paum007/NR-Internship/circuit_design.png

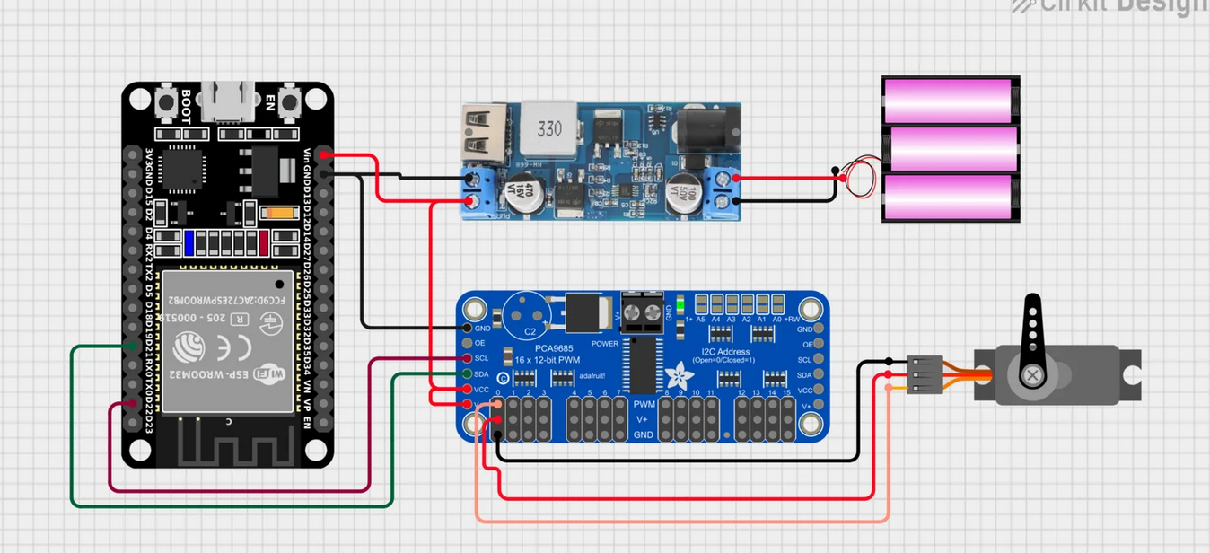
circuit_design.png
