paum007/NR-Internship/Pictures-and-videos/Dragonskin-60-mould.jpeg

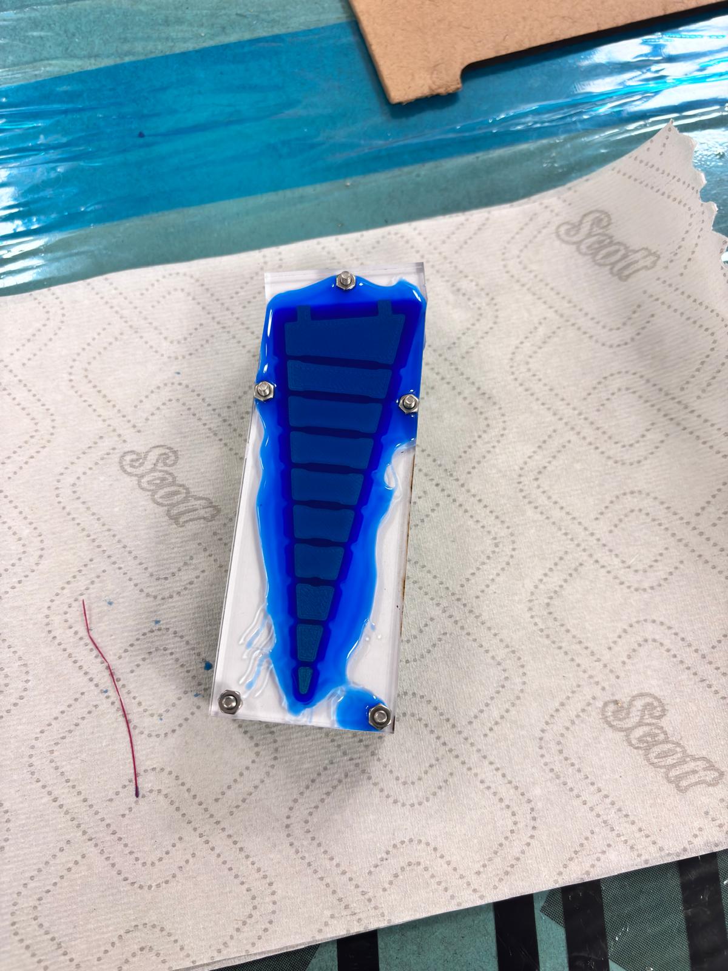
Pictures-and-videos/Dragonskin-60-mould.jpeg
