paum007/NR-Internship/Meeting notes/04-06-2026.md

For presenting: Use block diagrams that show the hardware and process of the project. Ask Adip the software that he used.
OpenVLA model for computer vision.

Take a look at the Dex MimicGEN: https://dexmimicgen.github.io/

Make an Excel Spreadsheet on the materials and equipment I'll need

RGB-D camera
