paum007/NR-Internship/Documents/Embodied Teleoperation and Imitation Learning for Human-like Robotic Manipulation.pptx

## Embodied Teleoperation and Imitation Learning for Human-like Robotic Manipulation

Pau M. Marcos

## OVERVIEW

- Hardware

- X-Arm
- Robotic hand end-effector with haptic feedback
- Cameras for computer vision
- IMU sensors for hand acceleration

- Manipulation

- Conducted testing with young business owners in the area

- Results

- Designed with the help and input of architecture experts in the field

- Testing

- First beautifully designed building that's both stylish and functional

Pitch deck title

## Workflow

## Timeline

## B.O.M.

Hand
Servos
Wire/fishing line
Haptic Sensors
Glove
Vision

## THANK YOU

- Mirjam Nilsson
- 206-555-0146
- mirjam@contoso.com
- www.contoso.com
