paum007/NR-Internship/Documents/NR Project Research.docx

# NR Project Research

Workflow, some ideas for the methodologies to be followed, equipment needed and a plan for the results.

- How are you going to get haptic feedback
- How are you going to move the arm accurately with a camera – remember to include something with the waypoints so that the arm knows which way to move
- How are the movements of the hand going to be translated to the robotic hand
- What are the plans for the results?

# E-Skin

There are types of actuators for the hand:

1. Linear Resonant Actuator: a small haptic device that vibrates linearly when driven by an AC signal. Can only convey pressure and no textures
2. Voice coil actuators: like tiny speakers pressed against skin. Better frequency response, can simulate textures.
3. Electrotactile stimulation: small electrodes pass tiny currents through skin to stimulate nerves directly. Very thin, high resolution, but tuning is tricky and sensation varies by person.
4. Shape memory alloys (SMA) or dielectric elastomer actuators (DEAs): research-grade, thin, but harder to drive.

## Linear Resonant Actuators

### What are they and how do they work?

An LRA Is a vibration motor that produces an oscillating force across a single axis. An LRA relies on an AC voltage to drive a voice coil pressed against a moving mass connected to a spring. When the voice coil is driven at the resonant frequency of the spring, the entire actuator vibrates with a perceptible force. Although the frequency and amplitude of a linear resonant actuator may be adjusted by changing the AC input, the actuator must be driven at its resonant frequency to generate a meaningful amount of force for a large current.

Although the frequency can be changed, the LRA will typically be operated within a narrow frequency range to optimise its power consumption; if the device is driven at the resonant frequency of the spring, it will consume less power to produce a vibration of equal magnitude.

The typical start time of the LRA is approximately 10ms. This incredible speed results from the immediate movement of the magnetic mass as current is applied to the voice coil inside of the device. Unfortunately, the stop time of the LRA can be longer. It can take up to 300ms to stop vibrating due to the continued storage of kinetic energy in the internal spring during operation. Thankfully, an active braking mechanism can also be used for an LRA—by performing an 180-degree phase shift of the AC signal provided to the actuator, the vibration can be stopped very quickly (within approximately 10ms) by producing a force opposite to the oscillation of the spring.

### Pros & Cons

Pros

- Size: Very small, good for physical flexibility.
- Price: These are cheap sensors (~£10).
- Fast response time.
- Long lifespan.
- Multidimensional haptic expression: it supports multi-mode waveform programming, this means it can be programmed to achieve various effects such as crisp clicks, gentle pulsations, gradual reminders, or complex sequences.

Cons

- More equipment needed to deal with the back current from the AC circuit
- High-performance loss: Vibration intensity drops sharply when the drive frequency deviates. A 10% deviation can cause a 30% or greater loss.
- Limited haptic effect: It is hard to maintain a consistent haptic experience over a wide frequency range. This limits the diversity of HD Haptics and complex waveforms.

### Feasibility and Expenses

The size and price make it feasible for the LRA to be used on a glove. These would be placed in between the joints in the hand and would act mainly to detect the pressure when the haptic sensors on the hand output a signal.

## Voice Coil Actuators

### What are they and how do they work?

VCAs are direct-drive, linear motors that offer precise motion control. They function by having an electric current flow through a voice coil, producing a magnetic force that drives linear movement.

They have 3 main components: the voice coil, the permanent magnet and the magnetically permeable core. The voice coil is a coil of wire, typically made of copper, wound around a bobbin. The permanent magnet generates a static magnetic field, while the core is used to concentrate the magnetic flux and provide a low-reluctance path for the flux lines.

When an electric current flows through the voice coil, it produces a magnetic field. This magnetic field interacts with the static magnetic field generated by the permanent magnet, creating a force. The direction and magnitude of these forces are determined by the direction and magnitude of the current flowing through the voice coil. This force is then transferred to the load, causing it to move in a linear motion.

### Types of VCAs

There are two types of VCAs: moving magnet and moving coil. In both types, the basic working principle remains the same, but the construction and arrangement of components differ.

#### Moving magnet VCAs

In a moving magnet VCA, the voice coil is stationary, while the permanent magnet is attached to the moving part of the actuator. This design has a lower moving mass and reduced inertia, allowing for faster response times and higher acceleration rates. However, the moving magnet design may be more susceptible to external magnetic fields and may require additional shielding (this might make it a bulkier design).

#### Moving coil VCAs

In a moving coil VCA, the permanent magnet is stationary, while the voice coil is attached to the moving part of the actuator. This design has the advantage of better heat dissipation (good for long usage), as the heat generated in the voice coil can be easily transferred to the surrounding environment. However, the moving coil design generally has a higher moving mass and inertia which may result in lower response times and lower acceleration rates compared to moving magnet VCAs (not good if the goal is to test for responsivity in remote environments).

### Pros & Cons

Pros

- High Precision: VCAs are capable of providing extremely precise positioning and control with resolutions down to the nanometre range.
- Fast Response: Due to their low moving mass and direct-drive design, VCAs can achieve very high acceleration rates and fast response times.
- Long Life: With no mechanical contact between the moving parts, VCAs have a long operational life and require minimal maintenance.
- Wide Force Range: The force generated by VCAs can be easily controlled by adjusting the current supplied to the voice coil, allowing for a wide range of forces to be produced.

Cons

- Larger and heavier — smallest practical size around 8–10mm, often thicker (4–6mm)
- Higher power draw, especially at low frequencies (which are inefficient)
- More complex driving: need an audio-style amplifier (Class D), not a simple haptic driver chip. You're essentially building a multi-channel audio system.
- More expensive: £10–30 per unit for decent quality
- Harder to find at small sizes from accessible suppliers
- Need to manage heat in continuous operation
- Frequency response varies with mounting pressure and skin contact — harder to calibrate consistently

### Feasibility and Expenses

Due to their more bulky and expensive nature, these can be used in the parts of the hand that are more used, this can include the fingertips. This will allow for some texture while the LRA can be used on the rest of the palm for pressure feedback.

## Electrotactile Stimulation Sensors

### What are they and how do they work?

Electrotactile stimulation is a fundamentally different approach to haptics: instead of mechanically pushing on skin, you pass small electrical currents through the skin to directly stimulate the sensory nerves underneath. The brain interprets these signals as touch sensations — tingling, pressure, vibration, or sharpness depending on how you drive them.

### Pros & Cons

Pros

- Ultra-thin: electrodes can be printed conductive ink, copper foil, or hydrogel pads — fractions of a millimetre thick. The glove can be genuinely skin-like.
- No moving parts: nothing to wear out, no resonant frequency limits, completely silent
- High spatial resolution: electrode pads can be 2–3mm, packed into dense arrays. Researchers have built 8×8 grids on a fingertip.
- Broadband sensation control: by varying frequency, pulse width, and amplitude independently, you can convey pressure, texture, vibration, and even sharpness/dullness
- Low power: microamps average current, runs forever on a small battery
- Fast response: no mechanical inertia, microsecond-scale onset
- Can stimulate specific receptor types: tuning parameters can preferentially excite Merkel cells (pressure), Meissner corpuscles (light touch), or Pacinian corpuscles (vibration)

Cons

- Sensation is unfamiliar and variable: it doesn't feel exactly like real touch, especially at first. Users describe it as "tingly pressure" or "buzzy sensation". Takes training to interpret.
- Highly person-dependent: skin impedance varies with hydration, hair, calluses, individual physiology. What feels gentle on one person feels sharp on another. Every user needs calibration.
- Sensitive to electrode contact: dry skin, sweat, electrode lift-off all changes the sensation. Hydrogel electrodes work best but dry out over hours.
- Narrow window between perceptible and painful: maybe a 3–5× range between "I feel it" and "ow". LRAs and VCAs have much wider comfort margins.
- Safety considerations: high voltage near skin requires proper isolation. Not dangerous when designed correctly (TENS units use the same principle medically), but you need to handle this seriously.
- Driver electronics are non-trivial: you need high-voltage boost converters, current-controlled output stages, biphasic pulse generation, and per-electrode multiplexing. Far more complex than driving an LRA.
- Regulatory friction: anything that puts current through skin can attract medical device classification if you commercialise. For personal/research use it's fine.
- Habituation and discomfort over time: prolonged stimulation can cause skin irritation, especially with gel electrodes. Sessions over an hour become uncomfortable.

## Dielectric Elastomer Actuators

### What are they and how do they work?

Dielectric elastomer actuators (DEA) are a class of electroactive polymers which work based on inducing of deformation of an electric field. A common design of DEAs is to sandwich a soft insulating elastomer membrane between two compliant electrodes. When a voltage is applied between the electrodes, the arising electric field causes a decrease in thickness and increase in area of the membrane.

What If I do something like this (https://www.youtube.com/watch?v=2yF-SJcg3zQ) with the potentiometers as well as with VCAs

## PowerPoint plan:

- 5 informative slides
- block diagram, including inputs/outputs, methods, and arrows connecting them to show the overall flow.
- A Gantt chart with a bi-weekly plan of the expected tasks would also be very useful (look at the official proposal doc).
- you may also want to include the equipment already available in the lab.

Parts list:

- Flex resistors x5 -> roughly £50
- HEEPDD Haptic Motor Controller DRV2605L Module, I2C Control Tactile Actuator Board Development Tool for Vibration Feedback in Robotics and Smartphones, High Performance Programmable Motor Driver -> roughly another £50
- ESP32 x2 -> already have so, £0
- Glove -> £2
- Servos for the hand -> already have so, £0
- Motors to provide resistance for the sensorised glove
- Also, VCA’s for haptic feedback on the tips of the fingers and possibly a bit of the hand as well
- Cable for the hand and the sensorised glove

Main issue is how do I detect if it’s grabbing something so that I can provide resistance on the glove?

Do I need encoders for the sensorised glove, or can it be done through resistance values?

I can test how long the cables need to be.

Find an already built hand design.

Ask for 3D printer access.
