paum007/NR-Internship/Documents/Presentation for NR Project GOOD.pptx

## Embodied Teleoperation and Imitation Learning for Human-like Robotic Manipulation

Pau M. Marcos

## Overview

- what it is + the contribution. Embodied teleoperation testbed; the thing that doesn't exist yet is the latency-swept dataset + reproducible benchmark. Lead with that, not the glove.

## Workflow

- Input/outputs
- Methods
- the closed loop as a diagram. Forward: hand → camera+IMU pose → IK → robot hand. Return: robot fingertip force → tendon brake (hard-stop) + VCA (tactile). This is your one diagram slide and the spine of the whole talk.

## Testing and Results

- NASA-TLX
- YCB object Dataset
- Replicability

## Method

- The method + why — combine the design problem, the alternatives, and your choice onto one slide. This is the compression that hurts, but it's the right call: pose "how do you render rigid resistance?", show the methods compressed to a small comparison (motor / brake / pad / pneumatic on the axes that matter), and land on the brake — resist-only is sufficient for rigid contact, so the brake wins on weight/power/safety/crispness. The "different methods" you originally wanted now live as a compact comparison here rather than their own section. You keep the "I navigated a design space" credibility without spending a whole slide on it.
- Equipment: X-Arm and access to the 3D printers, depth camera

## Timeline

- 9-weeks
- One week left de colchón por si necesito más tiempo en otras cosas o improvements

## Equipment Access

- wrist real-estate for five brakes, human↔robot finger mapping, and haptic-onset delay tying back to the latency theme. Close on the contribution again.
