paum007/NR-Internship/Documents/Embodied Teleoperation and Imitation Learning for Human-like Robotic Manipulation Presentation.pptx

01 / 05

Embodied Teleoperation and Imitation Learning for Human-like Robotic Manipulation

Real-time human control of a robotic hand and arm under controlled communication delay

Pau M. Marcos

## Slide 2

SYSTEM WORKFLOW

Control Loop

02 / 05

Return · feedback

Forward · command

Operator hand
flex sensor per finger

Camera + IMU
fused 6-DoF wrist pose

IK + mapping
human → end-effector

Robot hand
5 servos close

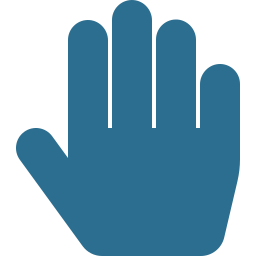
[picture p3: figure]
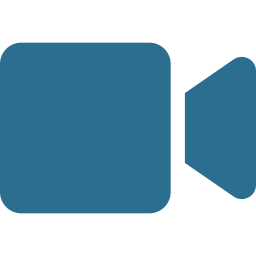
[picture p4: figure]
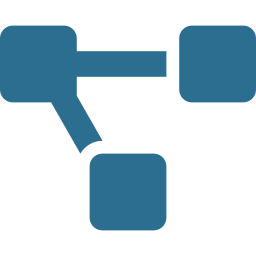
[picture p5: figure]
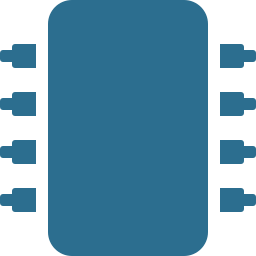
[picture p6: figure]

Tendon brake · kinesthetic
servo-clamp locks the close → hard stop

Contact
fingertip force sensed

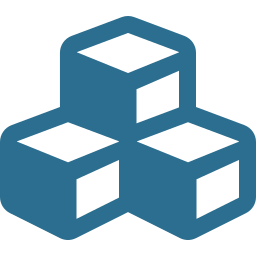
[picture p7: figure]

VCA · tactile
fingertip buzz on contact onset

The return path is part of the latency under study.
Haptic onset delay is a delay in this loop.

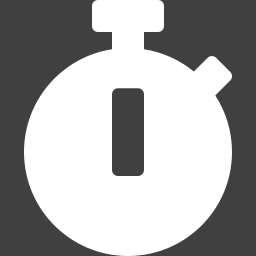
[picture p8: figure]

## Slide 3

RENDERING RESISTANCE

Feeling a rigid object: the tendon brake

03 / 05

Key insight: rigid contact is a hard stop, not a generated force. So, the device only needs to resist.

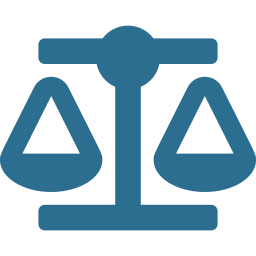
[picture p9: figure]

The per-finger method: command + resistance

A flex sensor on each glove finger sets its robot finger's position
Bend a finger and the matching robot finger closes — five fingers, five independent position commands.

Resist-only — all a rigid hard stop needs

No motor weight, power or safety burden

Crisp, fast lock feels like a real wall

Servo-clamp build reuses the ESP32

1

2

A tendon also runs along each glove finger
Anchored at the fingertip, routed back to a servo-driven clamp grounded against the hand / forearm.

3

On contact, the robot's fingertip force sensor fires
When that finger meets a rigid object, it raises a contact signal.

4

The clamp locks the tendon
The finger can't flex further; push harder and you feel more, like pressing a real wall.

Scope: rigid YCB subset only (boxes, cans). A rigid object never compresses, so a hard stop is sufficient — deformables would need force-dependent output and are out of scope.

## Slide 4

TESTING & RESULTS

Workload is what decides feasibility

04 / 05

PROTOCOL

Within-subjects:
each operator runs every condition.
Latency sweep (0 → <5 s) × haptic mode (brake on / off).
Counterbalanced order to cancel fatigue & learning effects.
Raw NASA-TLX taken immediately after each condition.

THE FEASIBILITY CEILING

Objective metrics say whether the task can be done. NASA-TLX says what it costs. As delay grows, success can hold while workload climbs — the point where workload turns unsustainable, though the task is still completable, is the feasibility ceiling. That gap, not task failure, limits real deployment.

MEASURES

Objective — can the task be done?
completion time · success rate · contact force
Subjective — what does it cost the operator?
NASA-TLX workload (mental, physical, temporal, performance, effort, frustration)

WHY IT MATTERS

Deployment — a system that's completable but cognitively punishing isn't usable for hazardous or remote work.
Contribution — workload becomes a logged axis of the dataset. Most teleoperation benchmarks record only objective metrics; adding a subjective-workload dimension is part of what makes this one reusable.

## Slide 5

10-WEEK WORK PLAN

Phased build

05 / 05

W1–2

System Setup + Hardware Integration

Depth camera, skeletal tracking, initial robot-hand interface, glove input.

W3–4

Control + Mapping Development

Human→robot motion mapping, IK, per-finger gripper actuation, stable loop.

W5–6

ROS2 Integration

Comms pipeline and configurable delay module (<5 s); nominal validation.

W7–8

Testing + Experimental Benchmarking

Contact-rich pick-and-place across latency & haptic modes; log time, success, force, NASA-TLX.

W9–10

Data Analysis + Learning Extension

Dataset → state-action pairs; demo-quality & degradation trends under delay.
