paum007/NR-Internship/Pictures-and-videos/Dragonskin-60-mould-1.jpeg

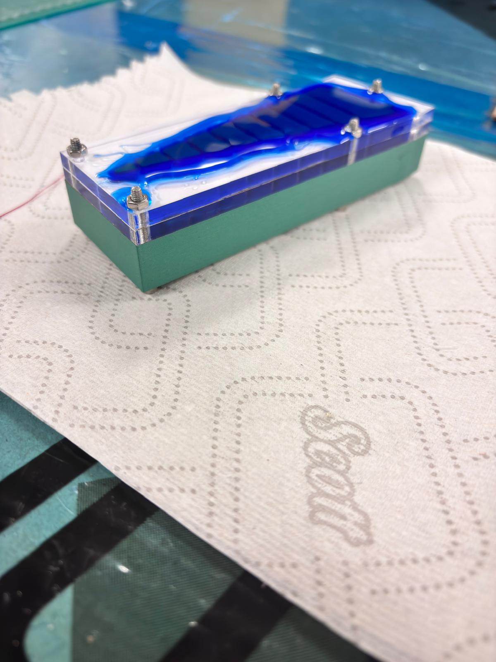
Pictures-and-videos/Dragonskin-60-mould-1.jpeg
