paum007/NR-Internship/Pictures-and-videos/Gripper-1.jpeg

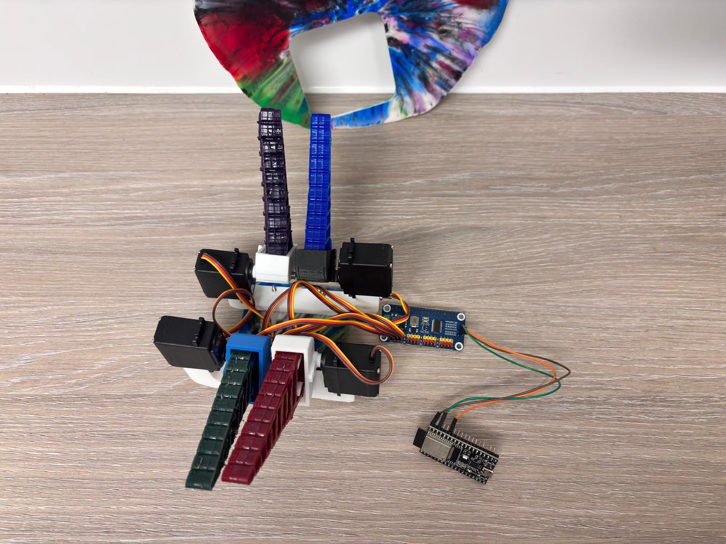
Pictures-and-videos/Gripper-1.jpeg
