paum007/NR-Internship/Pictures-and-videos/Gripper-2.jpeg

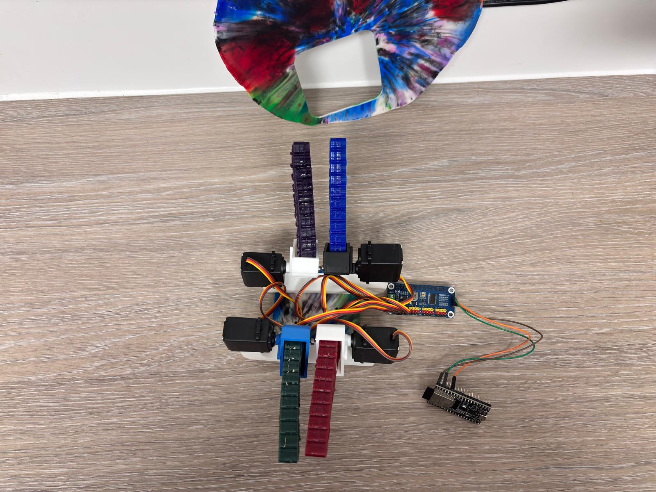
Pictures-and-videos/Gripper-2.jpeg
