paum007/NR-Internship/Pictures-and-videos/Gripper-3.jpeg

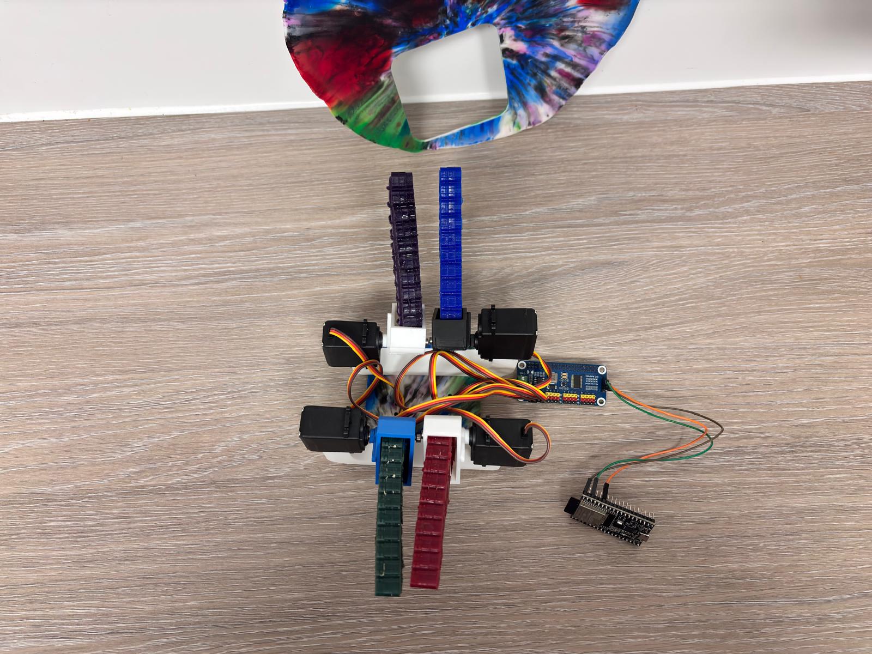
Pictures-and-videos/Gripper-3.jpeg
