paum007/NR-Internship/Pictures-and-videos/Gripper-4.jpeg

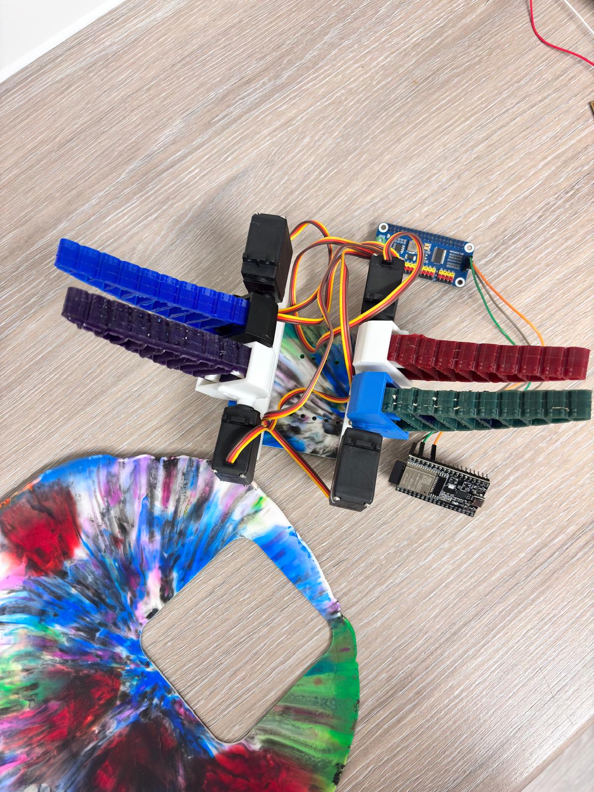
Pictures-and-videos/Gripper-4.jpeg
