paum007/NR-Internship/Pictures-and-videos/Plastic-sheet.jpeg

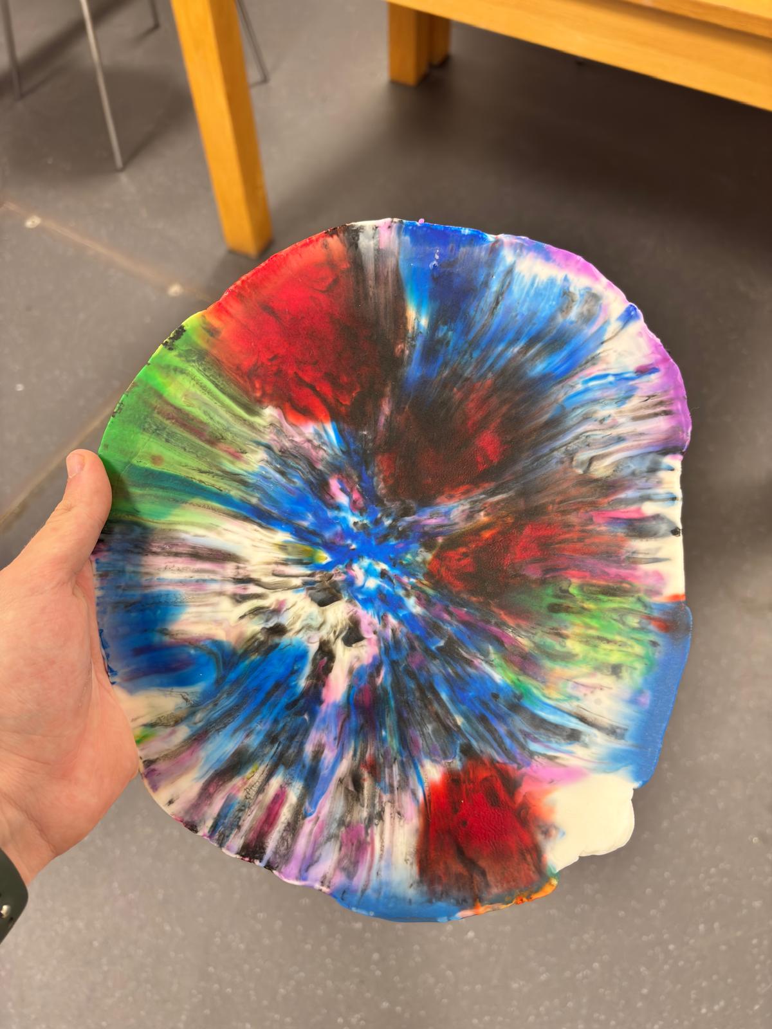
Pictures-and-videos/Plastic-sheet.jpeg
