paum007/NR-Internship/Pictures-and-videos/Plastic-waste-before-melting.jpeg

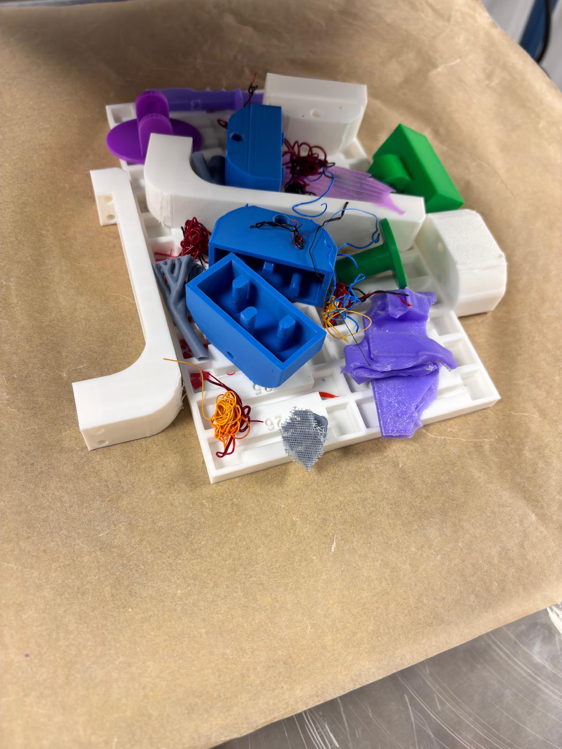
Pictures-and-videos/Plastic-waste-before-melting.jpeg
