paum007/NR-Internship/Pictures-and-videos/Vytaflex-mould.jpeg

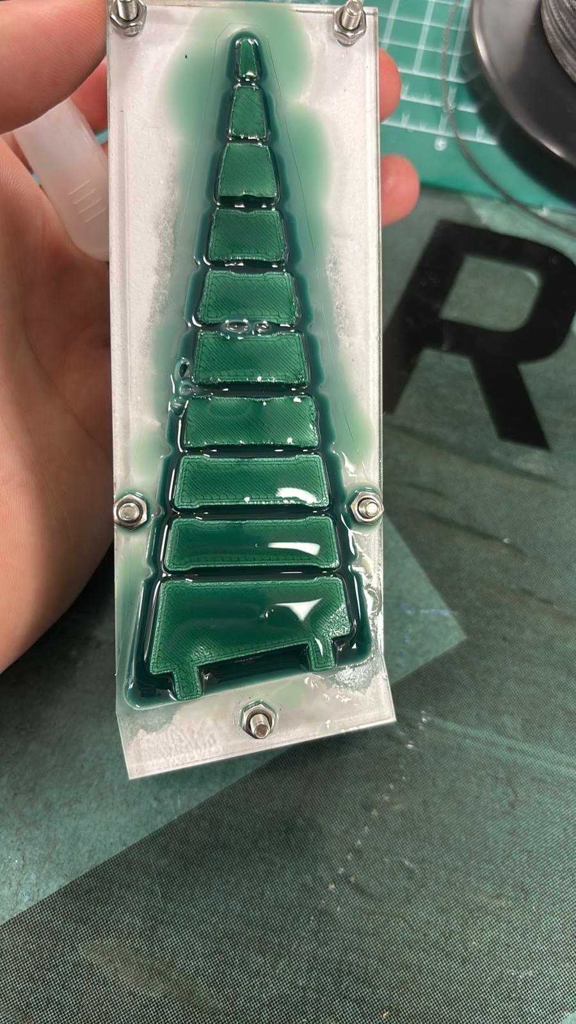
Pictures-and-videos/Vytaflex-mould.jpeg
