paum007/NR-Internship/CAD/xArm6 coupler.stl

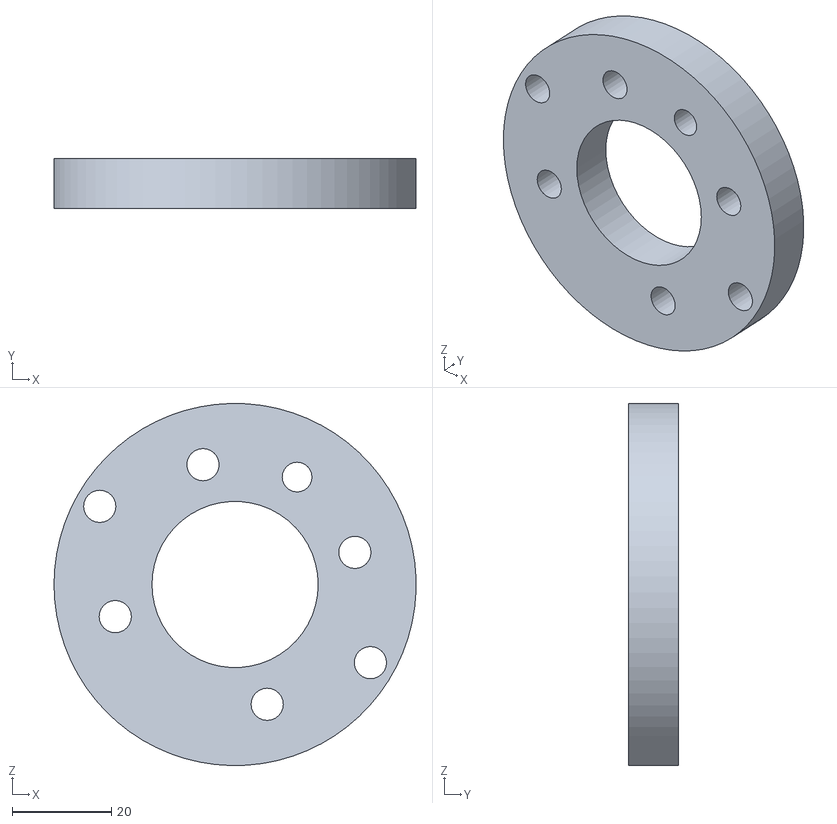
[picture p18: CAD file, 2026-08-27]
CAD/xArm6 coupler.stl
73.0 x 10.0 x 73.0
