paum007/NR-Internship/CAD/Finray laser file.dxf

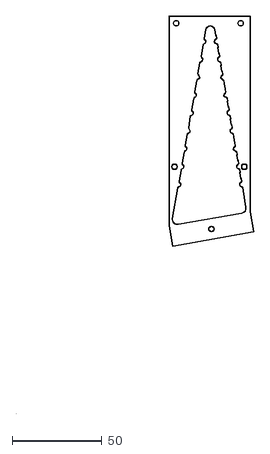
[picture p19: CAD file, 2026-08-24]
CAD/Finray laser file.dxf
132.5 x 221.8
