paum007/NR-Internship/CAD/Configuración 1.stl

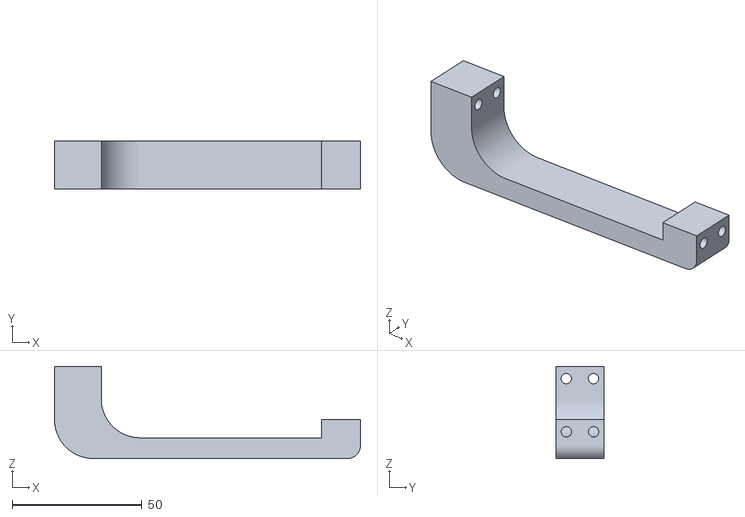
[picture p20: CAD file, 2026-08-24]
CAD/Configuración 1.stl
118.0 x 18.4 x 35.5
