paum007/NR-Internship/CAD/finray-mount.stl

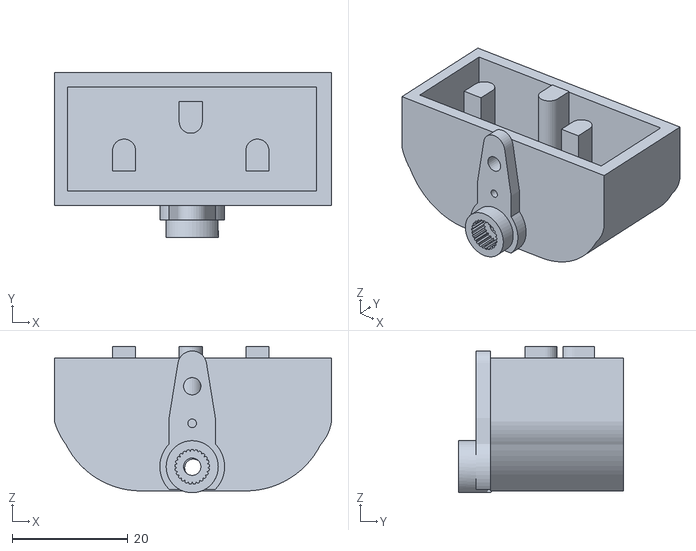
[picture p21: CAD file, 2026-08-24]
CAD/finray-mount.stl
47.9 x 28.5 x 25.3
