paum007/NR-Internship/CAD/flipped-finray-mount.stl

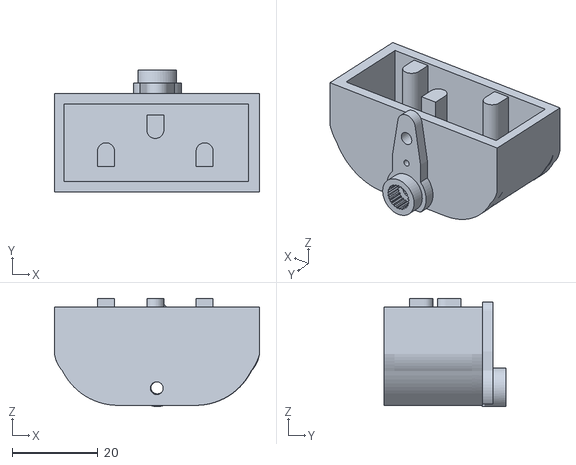
[picture p22: CAD file, 2026-08-24]
CAD/flipped-finray-mount.stl
47.9 x 28.5 x 25.3
