paum007/NR-Internship/CAD/MG966R-arm-pad.stl

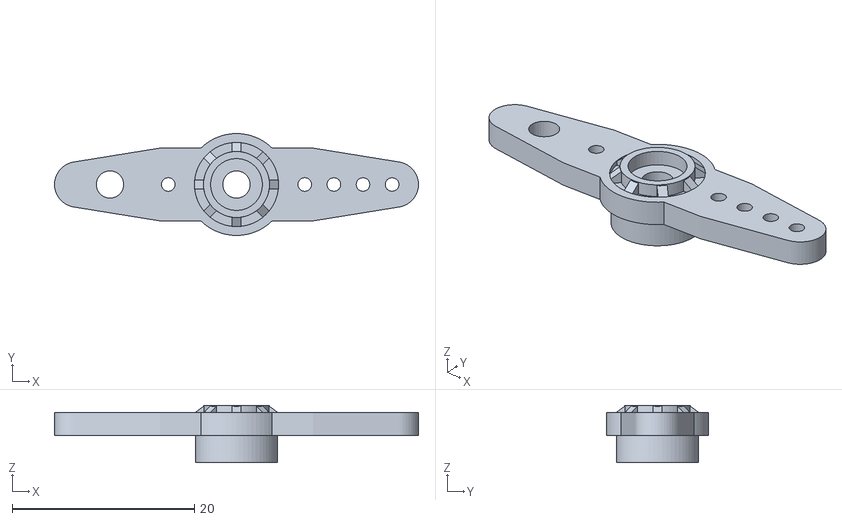
[picture p23: CAD file, 2026-08-24]
CAD/MG966R-arm-pad.stl
40.0 x 11.2 x 6.30
