paum007/NR-Internship/CAD/Finray mould v4.stl

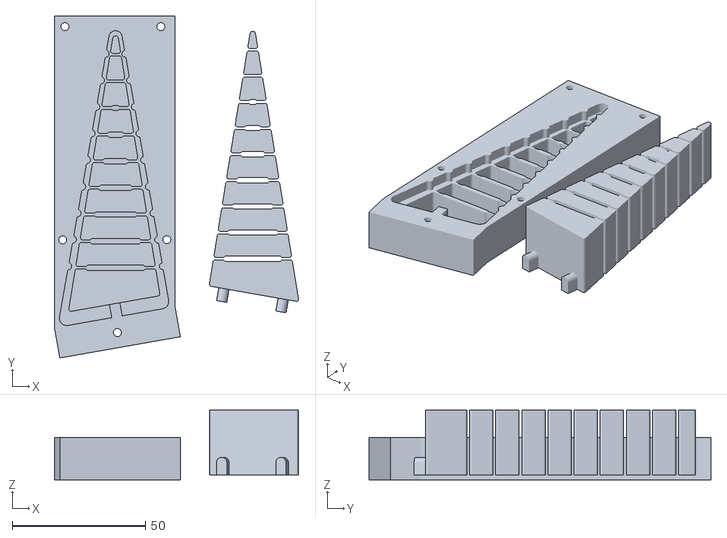
[picture p24: CAD file, 2026-08-04]
CAD/Finray mould v4.stl
91.6 x 128.3 x 26.2
