paum007/NR-Internship/CAD/Finray Attachment v1.stl

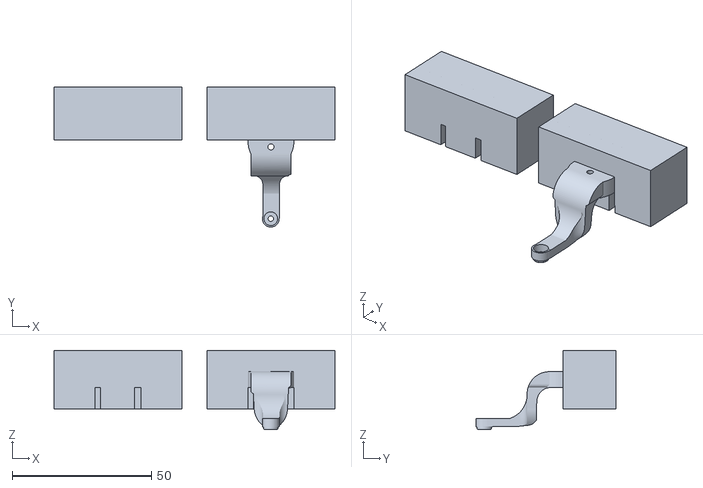
[picture p25: CAD file, 2026-07-31]
CAD/Finray Attachment v1.stl
101.0 x 50.4 x 28.5
