paum007/NR-Internship/(list of files, cad)

Other CAD files:
CAD/Finray Attachment v1.f3z
CAD/Finray mould v4.f3d
CAD/xArm6 coupler.f3d
