paum007/NR-Internship/esp_src/pio_ws/src/pca9685_testing.cpp

// This file was used to test the PCA9685 servo board to get familiar with it

#include <Wire.h>

// Include Adafruit PCA9685 Servo Library
#include <Adafruit_PWMServoDriver.h>

// Create object to represent PCA9685 at default I2C address
Adafruit_PWMServoDriver pca9685 = Adafruit_PWMServoDriver(0x40);

#define SERVOMIN 80  // Minimum value
#define SERVOMAX 600  // Maximum value
#define SER0 0   //Servo Motor 0 on connector 0
#define SER1 12  //Servo Motor 1 on connector 12

// Variables for Servo Motor positions (expand as required)
int pwm0;
int pwm1;

void setup() {
    
    // Serial monitor setup
    Serial.begin(115200);// Print to monitor
    Serial.println("PCA9685 Servo Test");// Initialize PCA9685
    pca9685.begin();
    pca9685.setPWMFreq(50);} // set pwm frequency to 50Hz
    
void loop() {
    
    // Move Motor 0 from 0 to 180 degrees
    for (int posDegrees = 0; posDegrees <= 180; posDegrees++) {
        
        // Determine PWM pulse width
        pwm0 = map(posDegrees, 0, 180, SERVOMIN, SERVOMAX);
        // Write to PCA9685
        pca9685.setPWM(SER0, 0, pwm0);
        // Print to serial monitor
        Serial.print("Motor 0 = ");
        Serial.println(posDegrees);
        delay(30);
    }
    
    // Move Motor 1 from 180 to 0 degrees
    for (int posDegrees = 180; posDegrees >= 0; posDegrees--) {
        
        // Determine PWM pulse width
        pwm1 = map(posDegrees, 0, 180, SERVOMIN, SERVOMAX);
        // Write to PCA9685
        pca9685.setPWM(SER1, 0, pwm1);
        pca9685.setPWM(1, 0, pwm1);
        pca9685.setPWM(7, 0, pwm1);
        // Print to serial monitor
        Serial.print("Motor 1 = ");
        Serial.println(posDegrees);
        delay(30);
    }
    
    // Move Motor 0 from 180 to 0 degrees
    for (int posDegrees = 180; posDegrees >= 0; posDegrees--) {
        
        // Determine PWM pulse width
        pwm0 = map(posDegrees, 0, 180, SERVOMIN, SERVOMAX);
        // Write to PCA9685
        pca9685.setPWM(SER0, 0, pwm0);
        pca9685.setPWM(SER1, 0, pwm0);
        pca9685.setPWM(1, 0, pwm0);
        pca9685.setPWM(7, 0, pwm0);
        // Print to serial monitor
        Serial.print("Motor 0 = ");
        Serial.println(posDegrees);
        delay(30);
    }
    
    // Move Motor 1 from 0 to 180 degrees
    for (int posDegrees = 0; posDegrees <= 180; posDegrees++) {
        
        // Determine PWM pulse width
        pwm1 = map(posDegrees, 0, 180, SERVOMIN, SERVOMAX);
        // Write to PCA9685
        pca9685.setPWM(SER1, 0, pwm1);
        // Print to serial monitor
        Serial.print("Motor 1 = ");
        Serial.println(posDegrees);
        delay(30);
    }

}
