paum007/NR-Internship/(commit log)

2026-06-04 File: Powerpoint on the planning and project initial ideas an dproposal
2026-06-04 File: Added a to-do list to keep track of the tasks
2026-06-07 Update: added a reminder to order a servo
2026-06-07 Feat: Finalised the hand design, it's compact and has space for the servos in a forearm-like container.
2026-06-08 FEAT: this file reads the data coming from the GY-521 IMU sensor
2026-06-08 FEAT: outputs the MAC address of the ESP32
2026-06-08 FEAT: this file receives the values from the potentiometer and moves the servos accordingly
2026-06-08 FEAT: config file for the ESP32. Tells the baudrate and settings as well as containing envs that push different code
2026-06-08 FEAT: very simple visualiser to se how the IMU sensor is working and how it's outputting data
2026-06-08 UPDATE: changed how the values are outputted by performing calculations so I can get pitch, roll and yaw
2026-06-16 NEW:CAD work for the haptic fingertip added
    [Fingertip1.stl]
2026-06-16 FEAT: This file moves 3 servos in a way that looks like a finger is curling
2026-06-16 UPDT: Added a print
2026-06-17 UPDT: Added settings for the printer and the datasheet for the magnetometer and stuff
2026-06-17 FEAT: Added the ros distro and the magnetometer code
2026-06-17 FEAT: Added code to read data from a magnetometer
2026-06-23 FEAT: Data gathering and data processing for the delay in microros
    [delay_data.csv]
2026-07-01 FEAT: Built the ROS2 workspace with the necessary files
    [delay_data.csv]
2026-07-02 FEAT: Made it to read a frame and output the angles between landmarks
2026-07-02 FEAT: Added an executor for the camera node
2026-07-02 FEAT: New node to read the angles from the mediapie node and translate them to the servo angles
2026-07-02 FEAT: Added a new environment for the new node to subscribe and move the servos
2026-07-08 FEAT: Added angle offset for claibration, a qos profile to change the way information is sent for smoother output, changed the way it's published in order to avoid overflowing.
    [mediapipe_node.py]
2026-07-08 FEAT: Added a qos profile to match the instructions of the mediapipe node, changed the way in which the data is processed after it is received, added sections to smooth the servos and decrease jitter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
    [finger_movement.cpp]
2026-07-09 FEAT: Added new servo attachment designs
    [Improved servo attachment v0.f3d, Improved servo attachment v0.stl, Improved servo attachment v1.f3d, Improved servo attachment v1.stl]
2026-07-10 Moved folders
    [delay_data.csv]
2026-07-22 Added a hand design
    [Improved servo attachment.f3d]
2026-07-28 FEAT: Added the finray mould
    [Finray mould v1.f3d, Finray mould v1.stl, Hand attachment v1.f3d, Improved servo attachment v0.f3d, Improved servo attachment v0.stl, Improved servo attachment v1.f3d, Improved servo attachment v1.stl, Improved servo attachment v2.f3d]
2026-07-28 FEAT: Added this to test the servo driver hat
2026-07-28 Added the circuit design
2026-07-29 FEAT: Added the new version of the finray mould with separable sections
    [Finray mould v2.f3d, Finray mould v2.stl]
2026-07-29 Added a new env to test the servo board
2026-07-29 FEAT: added some skeleton code to control the servo board
2026-07-31 FEAT: Added finray model files for the servo attachments
    [Finray Attachment v1.f3z, Finray Attachment v1.stl]
2026-08-04 Changed so it's split in half and added wall
    [Finray mould v3.stl]
2026-08-04 Resized the inserts
    [Finray mould v3.stl]
2026-08-04 FEAT: Added files for laser cutting
    [Finray laser file.dxf, Finray laser file.f3d]
2026-08-04 Changed the 3D printed mould again
    [Finray mould v4.f3d, Finray mould v4.stl]
2026-08-05 FEAT: drive fingers via PCA9685 and fix micro-ROS connectivity
    Replace ESP32Servo/GPIO control with the Adafruit PCA9685 driver on
    channels 0-2 (index, middle, ring). Clamp incoming ROS angles to 0-180
    and make the ramp non-blocking (20ms step interval) so the executor keeps
    spinning. Set the DDS domain explicitly via rclc_support_init_with_options
    so the ESP32 lands on domain 42 instead of 0, and install the UDP transport
    directly because set_microros_wifi_transports() re-calls WiFi.begin() and
    breaks enterprise auth. Migrate the WPA2-enterprise calls to the new
    esp_eap_client API.
    [finger_movement.cpp]
2026-08-05 FIX: repair broken formatting in the PCA9685 test sketch
    The SERVOMIN define was glued onto the driver declaration line, so the
    sketch did not compile. Split the run-together lines and tidy spacing.
    [pca9685_testing.cpp]
2026-08-05 FIX: correct lib deps for the PCA9685 environments
    Rename the misspelled libdeps key to lib_deps in pca9685_testing, and
    swap ESP32Servo for the Adafruit PWM Servo Driver in finger_movement now
    that the servos run off the PCA9685.
2026-08-05 CHANGE: reduce HandAngles to one MCP joint per finger
    Drop the PIP/DIP fields and the pinky entirely; the current rig only has
    servos for the index, middle, ring and thumb MCP joints. Mirrored in the
    ESP32 extra_packages copy so both sides keep matching type hashes.
2026-08-05 CHANGE: only track MCP joints in the mediapipe node
    Comment out the PIP/DIP entries and remove the pinky so the published
    angles match the trimmed HandAngles message. Drop the now-unused
    index_pip angle offset.
2026-08-10 Added the filter node to the launch file
2026-08-10 Added a filter to filter out the mediapipe node and the quest data
2026-08-10 Commented the old filter node
2026-08-11 Cleaning up some rouge finger data
2026-08-14 Experimenting wiht designs
    [Finray Attachment odd.stl, Finray Attachment v2.stl, Finray mould inner slots.stl]
2026-08-17 Added new designs for the servos
    [Finray Attachment experiment.stl, New attachment testing redone.stl, New attachment testing.f3d, New attachment testing.stl, New with included servo slit.stl, servo attachment circle.stl]
2026-08-21 improved filter node
2026-08-24 Intense design testing
    [Configuración 1.stl, Finray Attachment experiment.stl, Finray Attachment odd.stl, MG996R REMODELING.3mf, MG996R REMODELING.stl, MG996R Servo connectors.f3z, MG996R attachment.stl, New attachment design with servo pad.stl]
2026-08-24 updating everything
    [Finray laser file.dxf]
2026-08-27 [DEL] Deleted a lot of uneccessary files to clear the repo
    [Fingertip1.stl, Finray Attachment v2.stl, Finray laser file.f3d, Finray mould inner slots.stl, Finray mould v1.f3d, Finray mould v1.stl, Finray mould v2.f3d, Finray mould v2.stl]
2026-11-03 Added pictures of the mould process, final gripper and a gripper demo.
